MRAC-IAAC/Wearable-Assistive-Robotics/Images/1st prototype.JPG

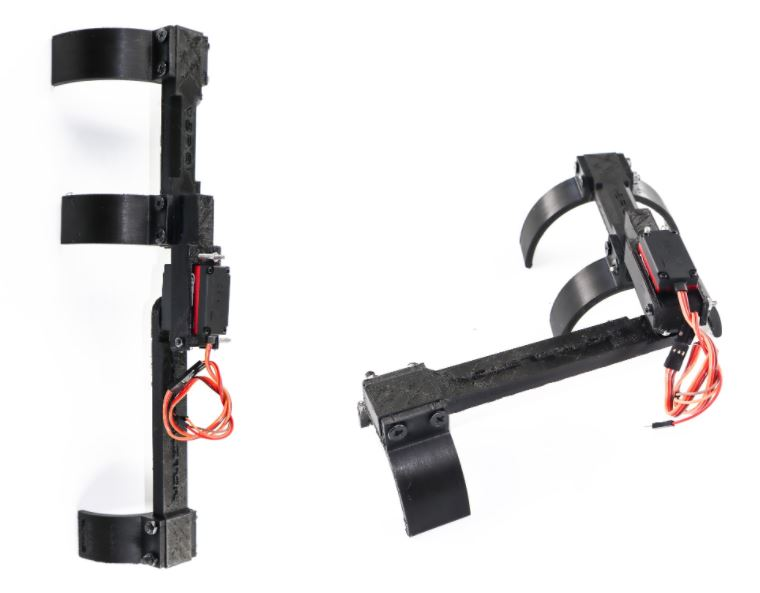
Images/1st prototype.JPG
