MRAC-IAAC/Wearable-Assistive-Robotics/Images/3d prototype - muscle locations.JPG

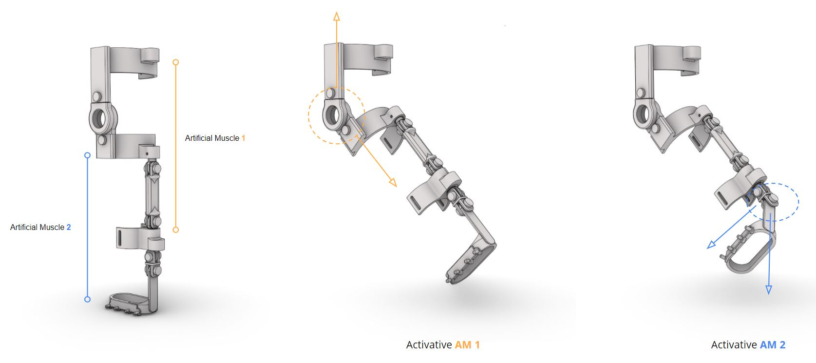
Images/3d prototype - muscle locations.JPG
